brianleu/eurorack/edges/hardware_design/Edges_Expander.xlsx

Edges Expander, v0.2
Index | Qty | Description | Specs | Value | Package | Ref. Mouser | References
SMT parts
R1 | 1 | Resistor, 1% |  | 220 | 0603 | 667-ERJ-PA3D2200V
R11 | 1 | Resistor, 1% |  | 1k | 0603 | 667-ERJ-3EKF1001V
R2 | 1 | Resistor, 1% |  | 4.7k | 0603 | 667-ERJ-3EKF4701V
R3, R5, R7 | 3 | Resistor, 1% |  | 10k | 0603 | 667-ERJ-PA3D1002V
R4, R6, R8, R9, R10 | 5 | Resistor, 1% |  | 20k | 0603 | 667-ERJ-3EKF2002V
C1, C2, C3, C4 | 4 | Capacitor, ceramic | >= 16V | 100n | 0603 | 81-GCJ188L81C104KA1D
C5 | 1 | Capacitor, electrolytic | >= 16V | 10u | Panasonic B | 598-AVE106M16B12T-F | Cornell Dubilier AVE106M16B12T-F
D1 | 1 | Silicon diode 1N4148 |  |  | SOD323 | 512-1N4148WS | Fairchild Semi 1N4148WS
IC1 | 1 | 7-Stage Binary Ripple Counter |  |  | SOIC14 | 771-74HC4024D-T | NXP 74HC4024D,653
IC2 | 1 | Quad 2-input Exclusive-OR gates |  |  | SOIC14 | 595-SN74LS86AD | Texas Instruments SN74LS86AD
IC3 | 1 | 250mA Output Dual SGL-Supply |  |  | SOIC8 | 584-AD8532ARZ | Analog Devices AD8532ARZ
OK1 | 1 | 6N137 Optocoupler |  |  | SMD-8 | 512-6N137SDM | Fairchild 6N137SDM or Everlight 6N137S(TB)
PTH parts, top side
J1 | 1 | Vertical jack connector |  |  |  |  | PJ-301-M-12
X1 | 1 | DIN Connector, vertical |  |  |  |  | Lumberg KGR-50
SW1, SW2 | 2 | Switch, 6mm |  |  |  | 612-TL1105SP-250 | E-switch TL1105SPF250Q
 | 2 | Cap for switch |  |  |  | 612-1R-BK | E-switch 1RBLK
PTH parts, bottom side
J18 (no label) | 2 | 2x3, 2.54mm pitch male header |  |  |  | 649-67996-406HLF
Ribbon Cable | 1 | 2x3 Pin IDC |  |  |  |  | https://www.adafruit.com/product/371
PCB specifications
PCB |  | 97.8 x 102.8 ; 2 layers
