brianleu/eurorack/edges/hardware_design/pcb/edges_expander_v01.brd

## EAGLE design edges/hardware_design/pcb/edges_expander_v01.brd (2018-10-20)

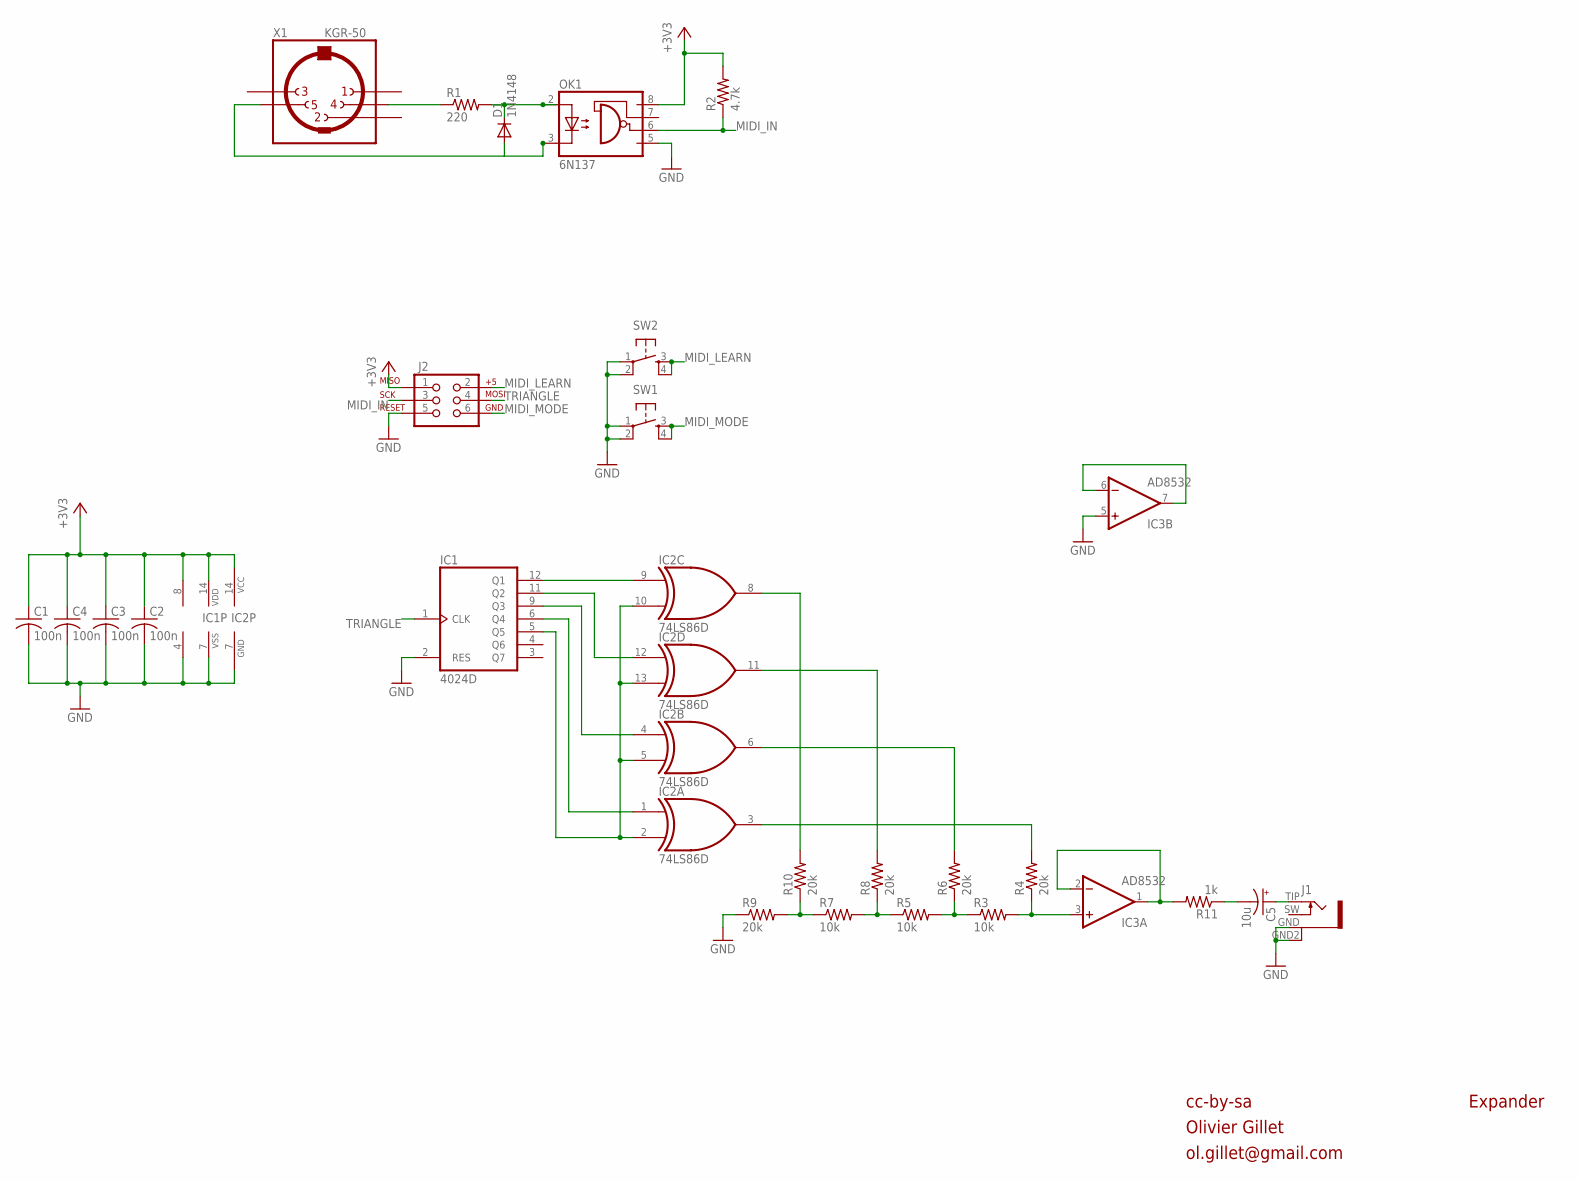
[picture p1: schematic edges_expander_v01.sch]

Parts:
C1, C2, C3, C4: 100n; C0603
C5: 10u; PANASONIC_B
D1: 1N4148; SOD323-W
IC1: 4024D; SO14
IC2: 74LS86D; SO14
IC3: AD8532; SO08
J1: PJ301WQP; WQP_PJ_301BM
J2: AVR_SPI_PRG_6PTH; 2X3
OK1: 6N137; DIL8-SMD
R1: 220; R0603
R2: 4.7k; R0603
R3, R5, R7: 10k; R0603
R4, R6, R8, R9, R10: 20k; R0603
R11: 1k; R0603
SW1, SW2: TAC_SWITCHPTH; TACTILE-PTH
X1: KGR-50

Connections:
+3V3_EXP: C1.1, C2.1, C3.1, C4.1, IC1.14 (VDD), IC2.14 (VCC), IC3.8 (V+), J2.1, OK1.8 (VCC), R2.2
GND: C1.2, C2.2, C3.2, C4.2, IC1.2 (RES), IC1.7 (VSS), IC2.7 (GND), IC3.4 (V-), IC3.5 (+IN), J1.GND (1), J1.GND2 (4), J2.5, OK1.5 (GND), R9.1, SW1.1, SW1.2, SW2.1, SW2.2
MIDI_IN: J2.3, OK1.6 (VO), R2.1
MIDI_IN4: R1.1, X1.P$4 (4)
MIDI_IN5: D1.A, OK1.3 (C), X1.P$5 (5)
MIDI_LEARN: J2.2, SW2.3, SW2.4
MIDI_MODE: J2.6, SW1.3, SW1.4
unnamed: IC2.3 (O), R4.2
unnamed: IC2.6 (O), R6.2
unnamed: IC2.11 (O), R8.2
unnamed: IC2.8 (O), R10.2
unnamed: D1.C, OK1.2 (A), R1.2
unnamed: IC1.5 (Q5), IC2.2 (I1), IC2.5 (I1), IC2.10 (I1), IC2.13 (I1)
unnamed: IC1.9 (Q3), IC2.4 (I0)
unnamed: IC1.11 (Q2), IC2.12 (I0)
unnamed: IC1.12 (Q1), IC2.9 (I0)
unnamed: IC3.6 (-IN), IC3.7 (OUT)
unnamed: IC1.6 (Q4), IC2.1 (I0)
unnamed: R7.1, R9.2, R10.1
unnamed: R5.1, R7.2, R8.1
unnamed: R3.1, R5.2, R6.1
unnamed: IC3.3 (+IN), R3.2, R4.1
unnamed: C5.-, R11.1
unnamed: IC3.1 (OUT), IC3.2 (-IN), R11.2
unnamed: C5.+, J1.TIP (2)
TRIANGLE: IC1.1 (CLK), J2.4

Notes on the sheet:
cc-by-sa
Olivier Gillet
ol.gillet@gmail.com
Expander

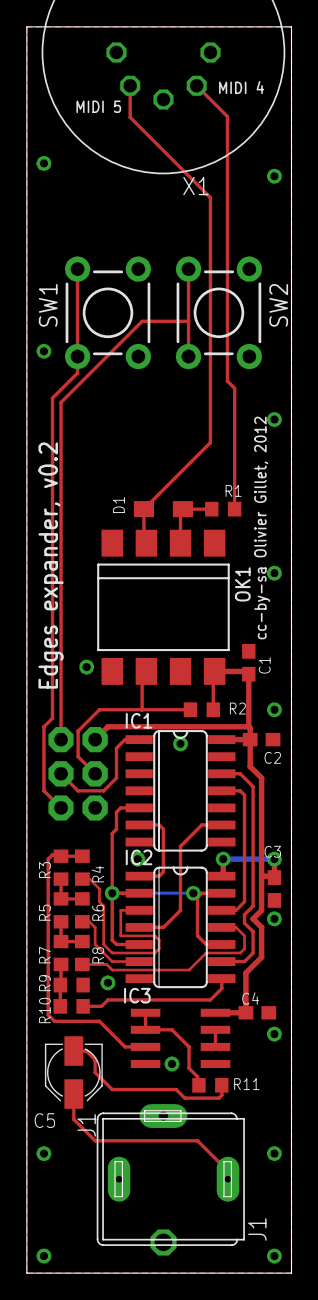
[picture p2: board edges_expander_v01.brd from above]

Board: 2 copper layers, 19.7 x 92.7 mm, 27 parts (1 on the bottom side), 26 nets.

Other parts of the board:
U$2: EURORACK_TEMPLATE
