brianleu/eurorack/(commit log)

2018-10-20 First pass at adding a through hole DIN connector to Edges expander
    [edges_expander_v01.brd, edges_expander_v01.sch]
2018-10-20 Add expander BOM and panel eagle brd
    [Edges_Expander.xlsx, edges_expander_panel.brd]
