brianleu/eurorack/(notices)

Notices in the files:
edges/hardware_design/pcb/edges_expander_v01.brd:
cc-by-sa Olivier Gillet, 2012
